jwgpro/devotion-kb-thinkpad/kb-only/production/bom-fix1.csv

Designator | Footprint | Quantity | Value | LCSC Part #
C1, C12, C2, C3, C4, C5, C6, C7 | 402 | 8 | 100n | C2168432
C10, C11, C20 | 402 | 3 | 1u | C2649511
C13, C14 | 402 | 2 | 10p | C22937232
C15, C16 | 805 | 2 | 22u | C318688
C17, C18 | 402 | 2 | 2u2 | C307419
C19, C9 | 402 | 2 | 10n | C437525
C8 | 603 | 1 | 10u | C77040
FB1 | 603 | 1 | 120R | C85831
J1 | PinHeader_1x04_P2.54mm_Vertical | 1 | Conn_01x04_Pin
J2 | Hirose_FH12-40S-0.5SH_1x40-1MP_P0.50mm_Horizontal | 1 | Conn_01x40 | C202114
P1 | USB_C_Receptacle_HRO_TYPE-C-31-M-12 | 1 | USB_C_Plug_USB2.0 | C963370
R1 | 402 | 1 | 10k | C2989267
R2 | 402 | 1 | 5k1 | C53109434
SW1 | SW_SPDT_PCM12 | 1 | SW_SPDT | C221841
U1 | LQFP-100_14x14mm_P0.5mm | 1 | STM32F401VET6 | C1337110
U2 | SOT-223-3_TabPin2 | 1 | AMS1117-3.3 | C6186
Y1 | Crystal_SMD_3225-4Pin_3.2x2.5mm | 1 | 16MHz | C112972
