jwgpro/devotion-kb-thinkpad/kb-only/devotion-kb-tp.kicad_pcb

## KiCad design kb-only/devotion-kb-tp.kicad_pcb (2026-10-22)

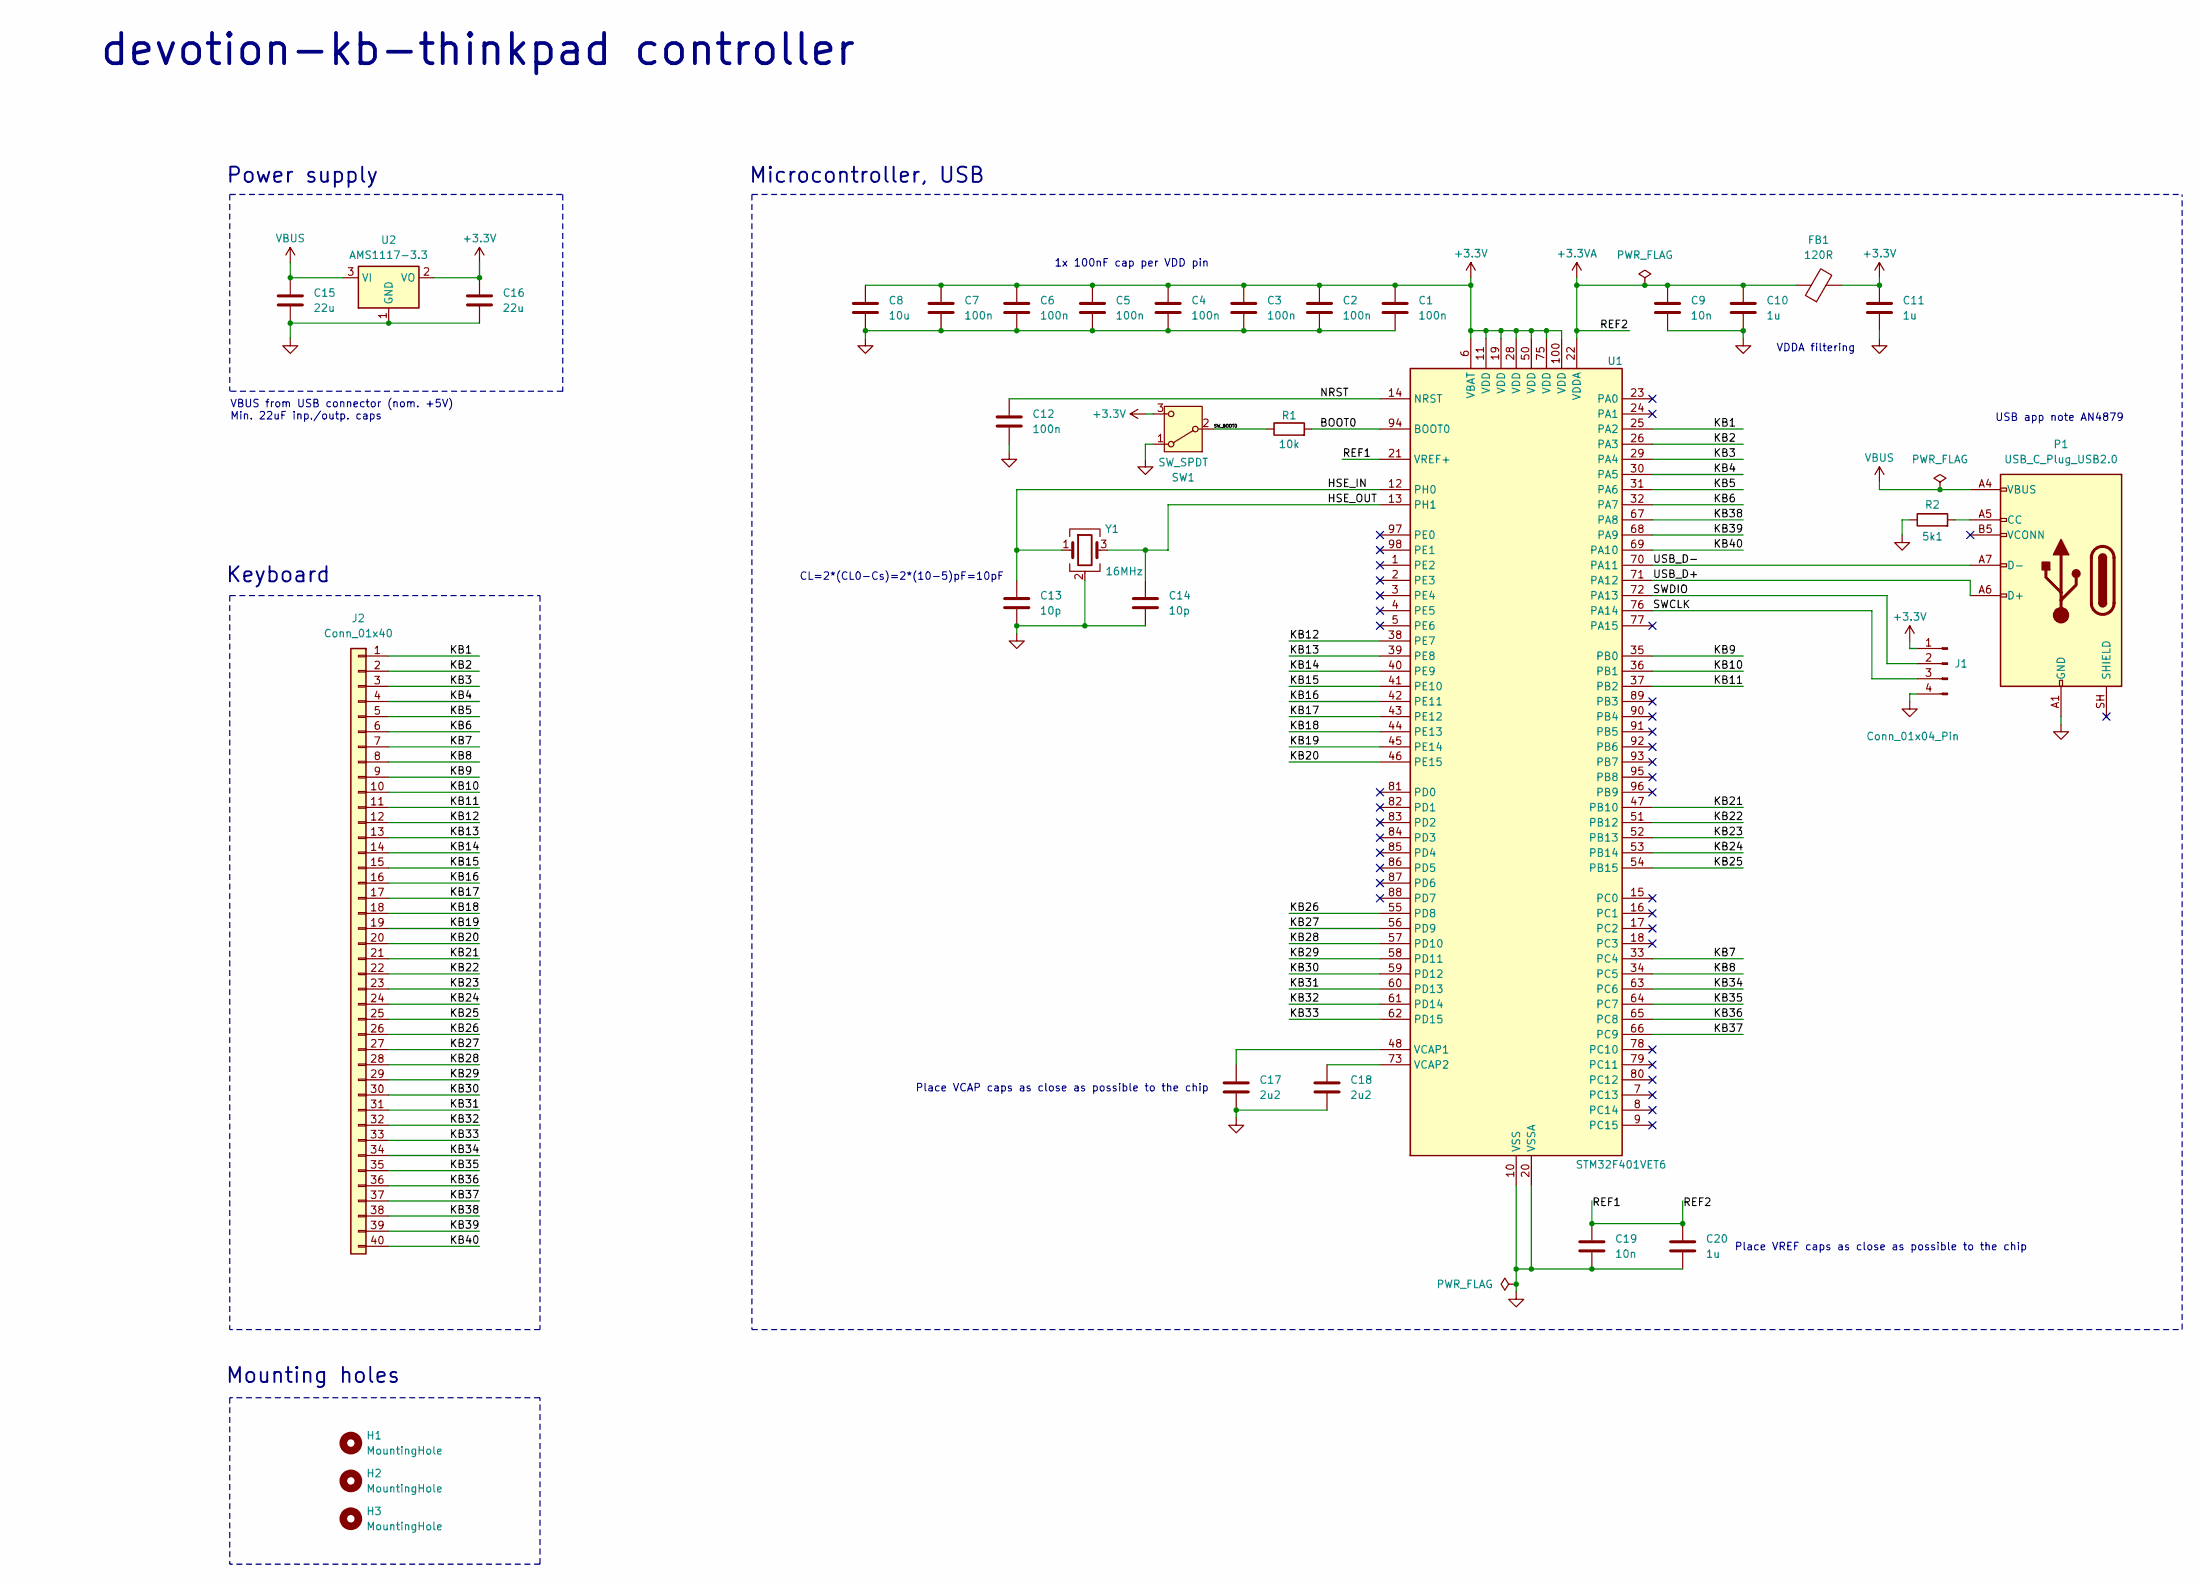
[picture p1: schematic devotion-kb-tp.kicad_sch, devotion-kb-thinkpad controller]

Parts:
C1, C2, C3, C4, C5, C6, C7, C12: 100n; C_0402_1005Metric
C8: 10u; C_0603_1608Metric
C9, C19: 10n; C_0402_1005Metric
C10, C11, C20: 1u; C_0402_1005Metric
C13, C14: 10p; C_0402_1005Metric
C15, C16: 22u; C_0805_2012Metric
C17, C18: 2u2; C_0402_1005Metric
FB1: 120R; L_0603_1608Metric
H1, H2, H3: MountingHole; MountingHole_3.5mm
J1: Conn_01x04_Pin; PinHeader_1x04_P2.54mm_Vertical
J2: Conn_01x40; Hirose_FH12-40S-0.5SH_1x40-1MP_P0.50mm_Horizontal
P1: USB_C_Plug_USB2.0; USB_C_Receptacle_HRO_TYPE-C-31-M-12
R1: 10k; R_0402_1005Metric
R2: 5k1; R_0402_1005Metric
SW1: SW_SPDT; SW_SPDT_PCM12
U1: STM32F401VET6; LQFP-100_14x14mm_P0.5mm
U2: AMS1117-3.3; SOT-223-3_TabPin2
Y1: 16MHz; Crystal_SMD_3225-4Pin_3.2x2.5mm

Connections:
+3.3V: C1.1, C2.1, C3.1, C4.1, C5.1, C6.1, C7.1, C8.1, C11.1, C16.1, FB1.2, J1.1, SW1.3 (C), U1.6 (VBAT), U1.11 (VDD), U1.19 (VDD), U1.28 (VDD), U1.50 (VDD), U1.75 (VDD), U1.100 (VDD), U2.2 (VO)
+3.3VA: C9.1, C10.1, C19.1, C20.1, FB1.1, U1.21 (VREF+), U1.22 (VDDA)
/BOOT0: R1.2, U1.94 (BOOT0)
/HSE_IN: C13.1, U1.12 (PH0), Y1.1
/HSE_OUT: C14.1, U1.13 (PH1), Y1.3
/KB1: J2.1, U1.25 (PA2)
/KB2: J2.2, U1.26 (PA3)
/KB3: J2.3, U1.29 (PA4)
/KB4: J2.4, U1.30 (PA5)
/KB5: J2.5, U1.31 (PA6)
/KB6: J2.6, U1.32 (PA7)
/KB7: J2.7, U1.33 (PC4)
/KB8: J2.8, U1.34 (PC5)
/KB9: J2.9, U1.35 (PB0)
/KB10: J2.10, U1.36 (PB1)
/KB11: J2.11, U1.37 (PB2)
/KB12: J2.12, U1.38 (PE7)
/KB13: J2.13, U1.39 (PE8)
/KB14: J2.14, U1.40 (PE9)
/KB15: J2.15, U1.41 (PE10)
/KB16: J2.16, U1.42 (PE11)
/KB17: J2.17, U1.43 (PE12)
/KB18: J2.18, U1.44 (PE13)
/KB19: J2.19, U1.45 (PE14)
/KB20: J2.20, U1.46 (PE15)
/KB21: J2.21, U1.47 (PB10)
/KB22: J2.22, U1.51 (PB12)
/KB23: J2.23, U1.52 (PB13)
/KB24: J2.24, U1.53 (PB14)
/KB25: J2.25, U1.54 (PB15)
/KB26: J2.26, U1.55 (PD8)
/KB27: J2.27, U1.56 (PD9)
/KB28: J2.28, U1.57 (PD10)
/KB29: J2.29, U1.58 (PD11)
/KB30: J2.30, U1.59 (PD12)
/KB31: J2.31, U1.60 (PD13)
/KB32: J2.32, U1.61 (PD14)
/KB33: J2.33, U1.62 (PD15)
/KB34: J2.34, U1.63 (PC6)
/KB35: J2.35, U1.64 (PC7)
/KB36: J2.36, U1.65 (PC8)
/KB37: J2.37, U1.66 (PC9)
/KB38: J2.38, U1.67 (PA8)
/KB39: J2.39, U1.68 (PA9)
/KB40: J2.40, U1.69 (PA10)
/NRST: C12.1, U1.14 (NRST)
/SWCLK: J1.3, U1.76 (PA14)
/SWDIO: J1.2, U1.72 (PA13)
/SW_BOOT0: R1.1, SW1.2 (B)
/USB_D+: P1.A6 (D+), U1.71 (PA12)
/USB_D-: P1.A7 (D-), U1.70 (PA11)
GND: C1.2, C2.2, C3.2, C4.2, C5.2, C6.2, C7.2, C8.2, C9.2, C10.2, C11.2, C12.2, C13.2, C14.2, C15.2, C16.2, C17.2, C18.2, C19.2, C20.2, J1.4, P1.A1 (GND), P1.A12 (GND), P1.B1 (GND), P1.B12 (GND), R2.1, SW1.1 (A), U1.10 (VSS), U1.20 (VSSA), U1.27 (VSS), U1.49 (VSS), U1.74 (VSS), U1.99 (VSS), U2.1 (GND), Y1.2 (G), Y1.4 (G)
unnamed: P1.A5 (CC), R2.2
unnamed: C17.1, U1.48 (VCAP1)
unnamed: C18.1, U1.73 (VCAP2)
VBUS: C15.1, P1.A4 (VBUS), P1.A9 (VBUS), P1.B4 (VBUS), P1.B9 (VBUS), U2.3 (VI)

Notes on the sheet:
Power supply
Keyboard
CL=2*(CL0-Cs)=2*(10-5)pF=10pF
1x 100nF cap per VDD pin
Microcontroller, USB
USB app note AN4879
VBUS from USB connector (nom. +5V) Min. 22uF inp./outp. caps
Place VREF caps as close as possible to the chip
VDDA filtering
Place VCAP caps as close as possible to the chip
devotion-kb-thinkpad controller
Mounting holes

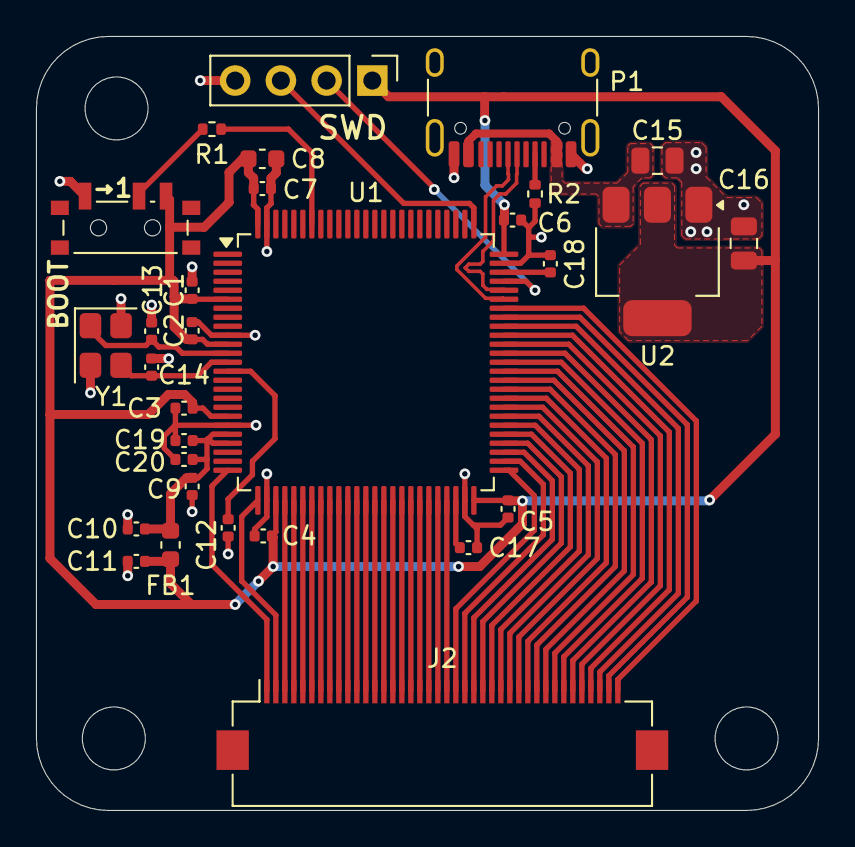
[picture p2: board devotion-kb-tp.kicad_pcb from above]

Board: 2 copper layers, 43.5 x 43.0 mm, 33 parts (0 on the bottom side), 56 nets.
