jwgpro/devotion-kb-thinkpad/(notices)

Notices in the files:
kb-only/devotion-kb-tp.kicad_pcb:
Licensed under CERN-OHL-S-2.0
